kamutelapo/smartmeterlogger/(list of files, drawings)

Other design files:
designspark/SmartMeterLogger.pcb
