kamutelapo/smartmeterlogger/arduino/arduino_secrets.h

#ifndef ARDUINO_SECRETS_H
#define ARDUINO_SECRETS_H

#define SECRET_SSID      "XXX"
#define SECRET_PASS      "XXX"

#define SECRET_MQTT_USER "XXX"
#define SECRET_MQTT_PASS "XXX"

#define MQTT_BROKER_HOST "MyHost"
#define MQTT_BROKER_PORT 1883
#define MQTT_TOPIC       "tele/smartmeter"


#endif /* ARDUINO_SECRETS_H */
