kamutelapo/smartmeterlogger/(commit log)

2023-08-09 PCB plan
    [SmartMeterLogger.pcb, SmartMeterLogger.sch]
2023-08-09 Arduino code
2023-08-09 Added: prototypes
2023-08-15 Switch signals
